shBLOCK/SnapNodes-RP2/hardware/PCB/Core_Length_Tuning_Profile.xlsx

Sheet: QSPI
SIGNAL | SEG1(MCU-SPI FLASH) | SEG2(SPI FLASH-PSRAM) | TOTAL | COMMENT | LEGEND
SCK | 14.852 | 15.5466 | 30.3986 |  |  | CHOSEN REFERENCE
D0 | 11.1338 | 15.5466 | 26.6804 |  |  | NOT GOOD
D1 | 14.852 | 14.0944 | 28.9464 |  |  | IGNORED
D2 | 14.852 | 15.5466 | 30.3986
D3 | 14.852 | 15.5466 | 30.3986
CS0 | 14.852 | 0 | 14.852
CS1 | 30.3986 | 0 | 30.3986 | USE TOTAL LENGTH AS REFERENCE |  | UNIT:mm

Sheet: PA
SIGNAL | SEG1(MCU-R) | SEG2(R-CONN) | TOTAL | COMMENT | LEGEND
CA | 12.7391 | 5.8326 | 18.5717 |  |  | CHOSEN REFERENCE
D0 | 16.706 | 1.8657 | 18.5717 |  |  | NOT GOOD
D1 | 17.3817 | 1.19 | 18.5717 |  |  | IGNORED
D2 | 17.3817 | 1.19 | 18.5717
D3 | 17.3817 | 1.19 | 18.5717
CB | 17.3817 | 1.19 | 18.5717
 |  |  |  |  |  | UNIT:mm

Sheet: PB
SIGNAL | SEG1(MCU-R) | SEG2(R-CONN) | TOTAL | COMMENT | LEGEND
CA | 26.7745 | 1.19 | 27.9645 |  |  | CHOSEN REFERENCE
D0 | 26.7745 | 1.19 | 27.9645 |  |  | NOT GOOD
D1 | 26.7745 | 1.19 | 27.9645 |  |  | IGNORED
D2 | 26.6745 | 1.29 | 27.9645
D3 | 26.6745 | 1.29 | 27.9645
CB | 26.6745 | 1.29 | 27.9645
 |  |  |  |  |  | UNIT:mm

Sheet: PC
SIGNAL | SEG1(MCU-R) | SEG2(R-CONN) | TOTAL | COMMENT | LEGEND
CA | 37.7886 | 1.19 | 38.9786 |  |  | CHOSEN REFERENCE
D0 | 37.7886 | 1.19 | 38.9786 |  |  | NOT GOOD
D1 | 37.7886 | 1.19 | 38.9786 |  |  | IGNORED
D2 | 36.8986 | 2.08 | 38.9786
D3 | 36.8986 | 2.08 | 38.9786
CB | 36.8986 | 2.08 | 38.9786
 |  |  |  |  |  | UNIT:mm

Sheet: PD
SIGNAL | SEG1(MCU-R) | SEG2(R-CONN) | TOTAL | COMMENT | LEGEND
CA | 24.7843 | 1.19 | 25.9743 |  |  | CHOSEN REFERENCE
D0 | 24.7843 | 1.19 | 25.9743 |  |  | NOT GOOD
D1 | 24.7843 | 1.19 | 25.9743 |  |  | IGNORED
D2 | 24.6742 | 1.3001 | 25.9743
D3 | 24.9742 | 1.0001 | 25.9743
CB | 24.7045 | 1.2698 | 25.9743
 |  |  |  |  |  | UNIT:mm
