shBLOCK/SnapNodes-RP2/hardware/PCB/SnapNodes_Breakout.kicad_pcb

## KiCad design hardware/PCB/SnapNodes_Breakout.kicad_pcb (2026-09-01)

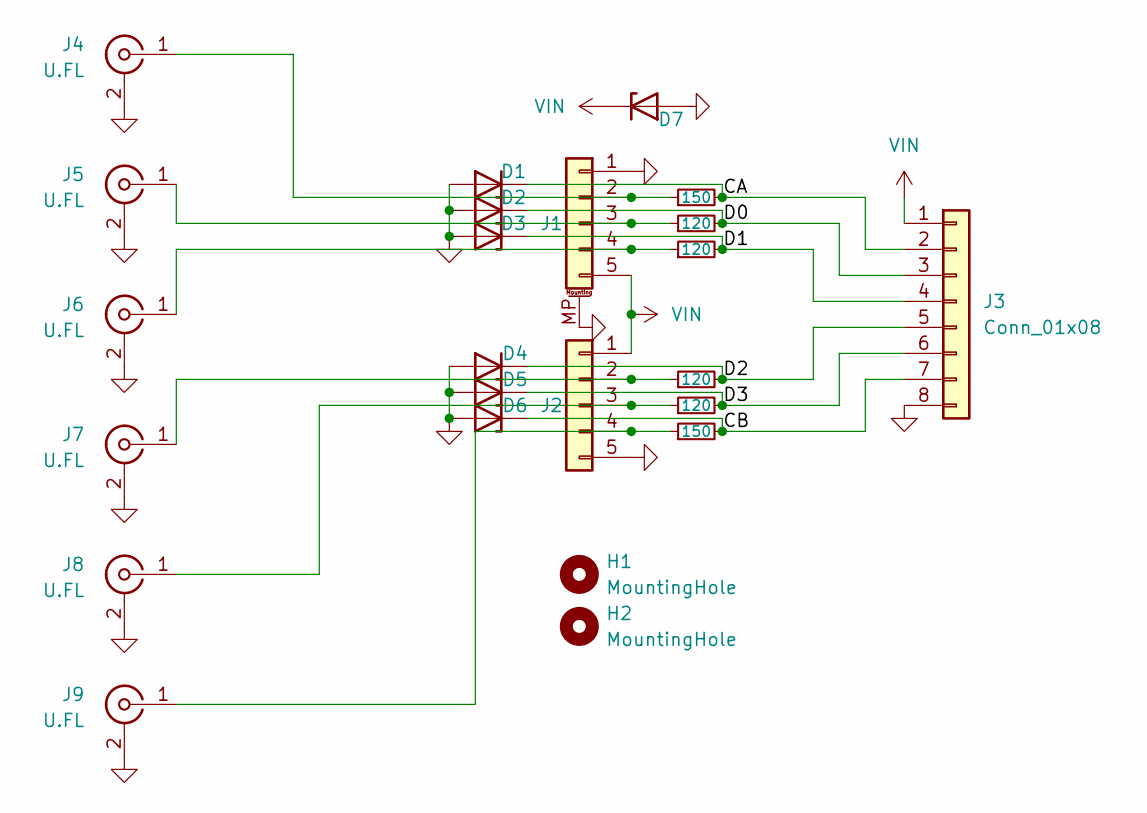
[picture p1: schematic SnapNodes_Breakout.kicad_sch, SnapNodes Breakout Board]

Parts:
D1, D2, D3, D4, D5, D6: PESD3V3S1BA; D_SOD-523; LCSC P/N C46550846
D7: PESD5V0S1BA; D_SOD-523; LCSC P/N C314264
H1, H2: MountingHole; MountingHole_2.2mm_M2
J1: P_Male; BC-15-5P380
J2: P_Female; BC-20-5PD160
J3: Conn_01x08; PinHeader_1x08_P2.54mm_Vertical
J4, J5, J6, J7, J8, J9: U.FL; U.FL_Hirose_U.FL-R-SMT-1_Vertical
R1, R6: 150; R_0402_1005Metric; LCSC P/N C25082
R2, R3, R4, R5: 120; R_0402_1005Metric; LCSC P/N C25079

Connections:
/CA: D1.1 (K), J3.2, R1.2
/CB: D6.1 (K), J3.7, R6.2
/D0: D2.1 (K), J3.3, R2.2
/D1: D3.1 (K), J3.4, R3.2
/D2: D4.1 (K), J3.5, R4.2
/D3: D5.1 (K), J3.6, R5.2
GND: D1.2 (A), D2.2 (A), D3.2 (A), D4.2 (A), D5.2 (A), D6.2 (A), D7.2 (A), J1.1, J1.MP (MountPin), J2.5, J3.8, J4.2 (Ext), J5.2 (Ext), J6.2 (Ext), J7.2 (Ext), J8.2 (Ext), J9.2 (Ext)
unnamed: J1.2, J4.1 (In), R1.1
unnamed: J1.3, J5.1 (In), R2.1
unnamed: J1.4, J6.1 (In), R3.1
unnamed: J2.2, J7.1 (In), R4.1
unnamed: J2.3, J8.1 (In), R5.1
unnamed: J2.4, J9.1 (In), R6.1
VIN: D7.1 (K), J1.5, J2.1, J3.1

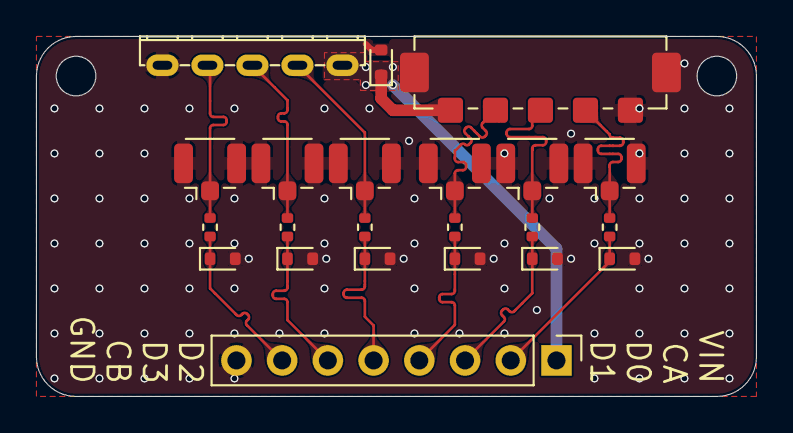
[picture p2: board SnapNodes_Breakout.kicad_pcb from above]

Board: 4 copper layers, 40.0 x 20.0 mm, 24 parts (0 on the bottom side), 14 nets.
