shBLOCK/SnapNodes-RP2/hardware/PCB/SnapNodes-RP2_Core.kicad_pcb

## KiCad design hardware/PCB/SnapNodes-RP2_Core.kicad_pcb (2026-09-01)

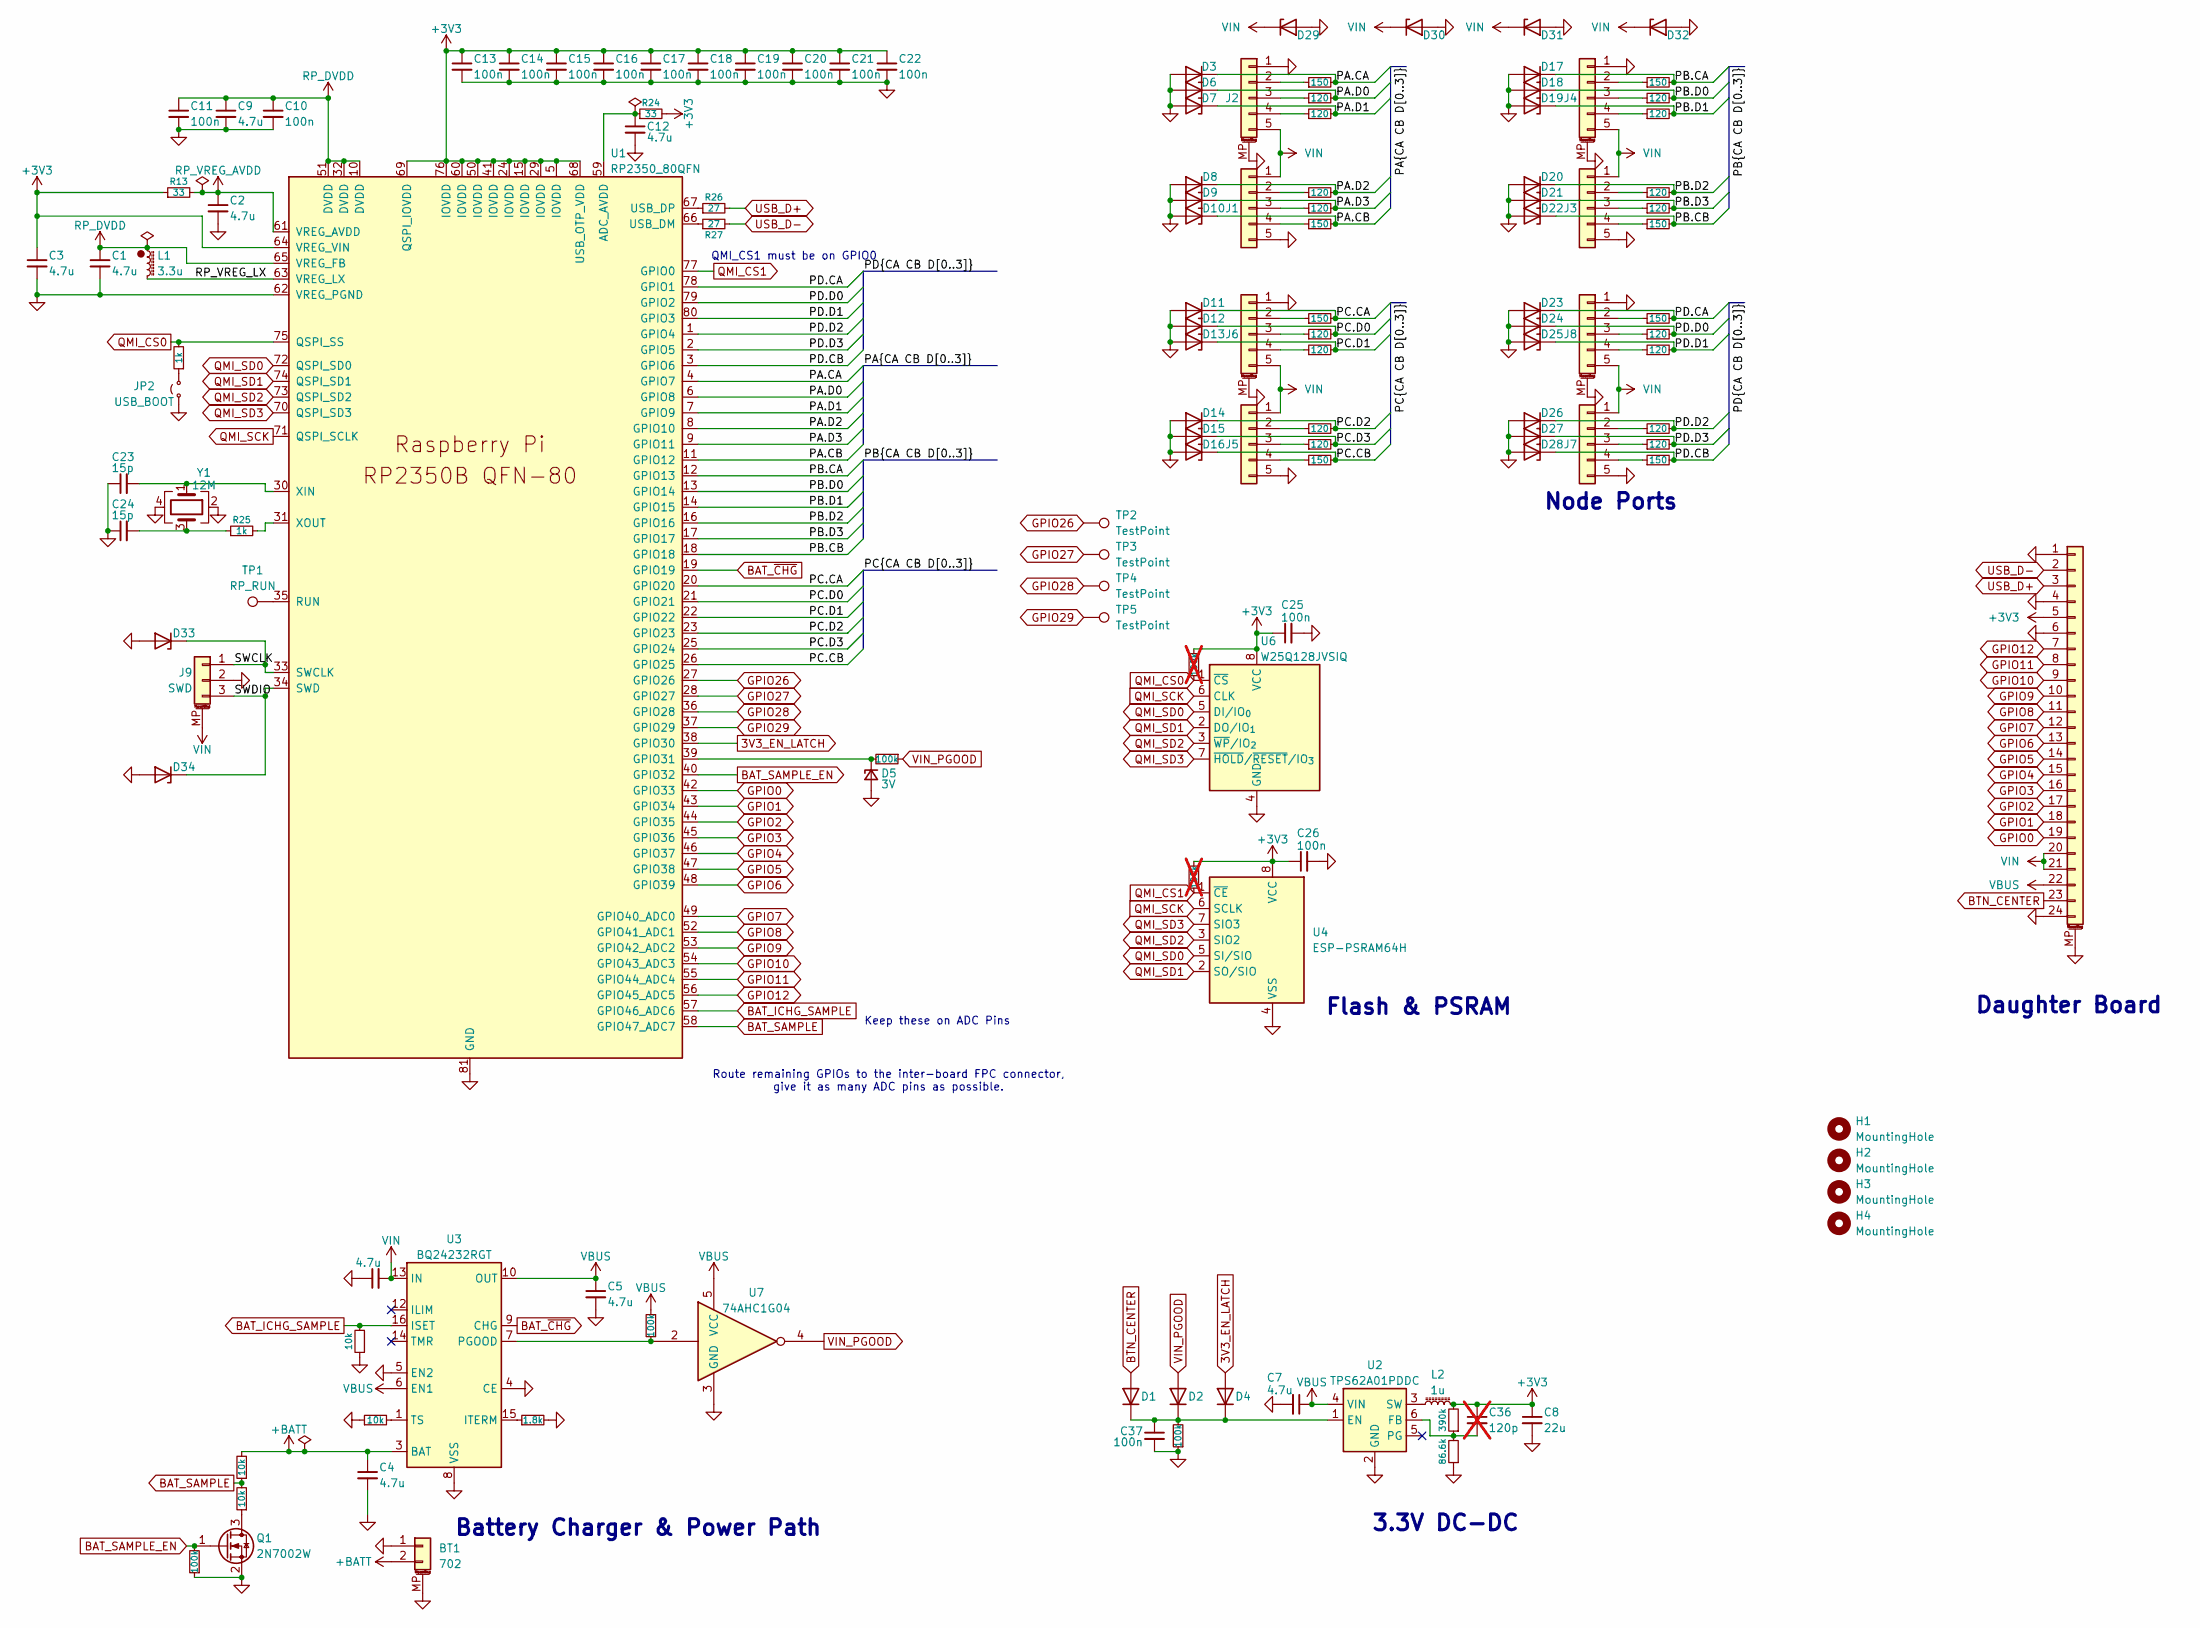
[picture p3: schematic SnapNodes-RP2_Core.kicad_sch, SnapNodes RP2 Core]

Parts:
BT1: 702; Molex_PicoBlade_53261-0271_1x02-1MP_P1.25mm_Horizontal; LCSC P/N C53477378
C1, C3: 4.7u; C_0402_1005Metric_small_pads; LCSC P/N C19666
C2, C4, C5, C6, C7, C9, C12: 4.7u; C_0402_1005Metric; LCSC P/N C19666
C8: 22u; C_0805_2012Metric; LCSC P/N C45783
C10, C11, C13, C14, C15, C16, C17, C18, C19, C20, C21, C22, C25, C26, C37: 100n; C_0402_1005Metric; LCSC P/N C1525
C23, C24: 15p; C_0402_1005Metric; LCSC P/N C1548
C36: 120p; C_0402_1005Metric; LCSC P/N C106996; not fitted
D1, D2, D4: 1N4148WT; D_SOD-523; LCSC P/N C7420320
D3, D6, D7, D8, D9, D10, D11, D12, D13, D14, D15, D16, D17, D18, D19, D20, D21, D22, D23, D24, D25, D26, D27, D28, D33, D34: PESD3V3S1BA; D_SOD-523; LCSC P/N C46550846
D5: 3V; D_SOD-523; LCSC P/N C2910134
D29, D30, D31, D32: PESD5V0S1BA; D_SOD-523; LCSC P/N C314264
H1, H2, H3, H4: MountingHole; MountingHole_2.2mm_M2
J1, J3, J5, J7: P_Female; BC-20-5PD160
J2, J4, J6, J8: P_Male; BC-15-5P380
J9: SWD; JST_SH_SM03B-SRSS-TB_1x03-1MP_P1.00mm_Horizontal; LCSC P/N C7430445
J20: Conn_01x24_MountingPin; FPC_Verticle_24pin_0.5mm; LCSC P/N C481246
JP2: USB_BOOT; PinHeader_1x02_P1.00mm_Vertical
L1: 3.3u; L_pol_2016; LCSC P/N C42411119
L2: 1u; L_Wuerth_MAPI-2010; LCSC P/N C7471163
Q1: 2N7002W; SOT-323_SC-70; LCSC P/N C7420322
R1, R4, R7, R10, R33, R37, R40, R43: 150; R_0402_1005Metric; LCSC P/N C25082
R2, R3, R5, R6, R8, R9, R11, R12, R31, R32, R35, R36, R38, R39, R41, R42: 120; R_0402_1005Metric; LCSC P/N C25079
R13, R24: 33; R_0402_1005Metric; LCSC P/N C25105
R14, R15, R17, R18: 10k; R_0402_1005Metric; LCSC P/N C25744
R16: 1.8k; R_0402_1005Metric; LCSC P/N C25871
R19, R22, R23, R34: 100k; R_0402_1005Metric; LCSC P/N C25741
R20: 86.6k; R_0402_1005Metric; LCSC P/N C19709
R21: 390k; R_0402_1005Metric; LCSC P/N C163467
R25, R30: 1k; R_0402_1005Metric; LCSC P/N C11702
R26, R27: 27; R_0402_1005Metric; LCSC P/N C25100
R28, R29: 100k; R_0402_1005Metric; LCSC P/N C25741; not fitted
TP1: RP_RUN; TestPoint_THTPad_D1.0mm_Drill0.5mm
TP2, TP3, TP4, TP5: TestPoint; TestPoint_Pad_D1.0mm
U1: RP2350_80QFN; RP2350-QFN-80-1EP_10x10_P0.4mm_EP3.4x3.4mm_ThermalVias; LCSC P/N C42415655
U2: TPS62A01PDDC; SOT-23-6; LCSC P/N C42267816
U3: BQ24232RGT; VQFN-16-1EP_3x3mm_P0.5mm_EP1.68x1.68mm_ThermalVias; LCSC P/N C528622
U4: ESP-PSRAM64H; SOIC-8_3.9x4.9mm_P1.27mm
U6: W25Q128JVSIQ; SOIC-8_5.3x5.3mm_P1.27mm; LCSC C113767
U7: 74AHC1G04; SOT-353_SC-70-5; LCSC P/N C52140422
Y1: 12M; Crystal_SMD_3225-4Pin_3.2x2.5mm; LCSC P/N C50430

Connections:
3V3_EN_LATCH: D4.2 (A), U1.38 (GPIO30)
+3V3: C3.1, C8.1, C13.1, C14.1, C15.1, C16.1, C17.1, C18.1, C19.1, C20.1, C21.1, C22.1, C25.1, C26.1, C36.1, J20.5, L2.2, R13.1, R21.2, R24.2, R28.2, R29.2, U1.5 (IOVDD), U1.15 (IOVDD), U1.24 (IOVDD), U1.29 (IOVDD), U1.41 (IOVDD), U1.50 (IOVDD), U1.60 (IOVDD), U1.64 (VREG_VIN), U1.68 (USB_OTP_VDD), U1.69 (QSPI_IOVDD), U1.76 (IOVDD), U4.8 (VCC), U6.8 (VCC)
+BATT: BT1.2, C4.1, R18.2, U3.2 (BAT), U3.3 (BAT)
/PA.CA: D3.1 (K), R1.2, U1.4 (GPIO7)
/PA.CB: D10.1 (K), R33.2, U1.11 (GPIO12)
/PA.D0: D6.1 (K), R31.2, U1.6 (GPIO8)
/PA.D1: D7.1 (K), R2.2, U1.7 (GPIO9)
/PA.D2: D8.1 (K), R32.2, U1.8 (GPIO10)
/PA.D3: D9.1 (K), R3.2, U1.9 (GPIO11)
/PB.CA: D17.1 (K), R4.2, U1.12 (GPIO13)
/PB.CB: D22.1 (K), R40.2, U1.18 (GPIO18)
/PB.D0: D18.1 (K), R38.2, U1.13 (GPIO14)
/PB.D1: D19.1 (K), R5.2, U1.14 (GPIO15)
/PB.D2: D20.1 (K), R39.2, U1.16 (GPIO16)
/PB.D3: D21.1 (K), R6.2, U1.17 (GPIO17)
/PC.CA: D11.1 (K), R7.2, U1.20 (GPIO20)
/PC.CB: D16.1 (K), R37.2, U1.26 (GPIO25)
/PC.D0: D12.1 (K), R35.2, U1.21 (GPIO21)
/PC.D1: D13.1 (K), R8.2, U1.22 (GPIO22)
/PC.D2: D14.1 (K), R36.2, U1.23 (GPIO23)
/PC.D3: D15.1 (K), R9.2, U1.25 (GPIO24)
/PD.CA: D23.1 (K), R10.2, U1.78 (GPIO1)
/PD.CB: D28.1 (K), R43.2, U1.3 (GPIO6)
/PD.D0: D24.1 (K), R41.2, U1.79 (GPIO2)
/PD.D1: D25.1 (K), R11.2, U1.80 (GPIO3)
/PD.D2: D26.1 (K), R42.2, U1.1 (GPIO4)
/PD.D3: D27.1 (K), R12.2, U1.2 (GPIO5)
/RP_VREG_LX: L1.2, U1.63 (VREG_LX)
/SWCLK: D33.1 (K), J9.1, U1.33 (SWCLK)
/SWDIO: D34.1 (K), J9.3, U1.34 (SWD)
BAT_ICHG_SAMPLE: R15.2, U1.57 (GPIO46_ADC6), U3.16 (ISET)
BAT_SAMPLE: R17.2, R18.1, U1.58 (GPIO47_ADC7)
BAT_SAMPLE_EN: Q1.1 (G), R19.2, U1.40 (GPIO32)
BAT_~CHG: U1.19 (GPIO19), U3.9 (CHG)
BTN_CENTER: D1.2 (A), J20.23
GND: BT1.1, BT1.MP (MountPin), C1.2, C2.2, C3.2, C4.2, C5.2, C6.1, C7.2, C8.2, C9.2, C10.2, C11.2, C12.2, C13.2, C14.2, C15.2, C16.2, C17.2, C18.2, C19.2, C20.2, C21.2, C22.2, C23.1, C24.1, C25.2, C26.2, C37.2, D3.2 (A), D5.2 (A), D6.2 (A), D7.2 (A), D8.2 (A), D9.2 (A), D10.2 (A), D11.2 (A), D12.2 (A), D13.2 (A), D14.2 (A), D15.2 (A), D16.2 (A), D17.2 (A), D18.2 (A), D19.2 (A), D20.2 (A), D21.2 (A), D22.2 (A), D23.2 (A), D24.2 (A), D25.2 (A), D26.2 (A), D27.2 (A), D28.2 (A), D29.2 (A), D30.2 (A), D31.2 (A), D32.2 (A), D33.2 (A), D34.2 (A), J1.5, J2.1, J2.MP (MountPin), J3.5, J4.1, J4.MP (MountPin), J5.5, J6.1, J6.MP (MountPin), J7.5, J8.1, J8.MP (MountPin), J9.2, J9.MP (MountPin), J20.1, J20.4, J20.6, J20.24, J20.MP (MountPin), JP2.1 (A), Q1.2 (S), R14.1, R15.1, R16.2, R19.1, R20.1, R34.1, U1.62 (VREG_PGND), U1.81 (GND), U2.2 (GND), U3.4 (CE), U3.5 (EN2), U3.8 (VSS), U3.17 (VSS), U4.4 (VSS), U6.4 (GND), U7.3 (GND), Y1.2, Y1.4
GPIO0: J20.19, U1.42 (GPIO33)
GPIO1: J20.18, U1.43 (GPIO34)
GPIO2: J20.17, U1.44 (GPIO35)
GPIO3: J20.16, U1.45 (GPIO36)
GPIO4: J20.15, U1.46 (GPIO37)
GPIO5: J20.14, U1.47 (GPIO38)
GPIO6: J20.13, U1.48 (GPIO39)
GPIO7: J20.12, U1.49 (GPIO40_ADC0)
GPIO8: J20.11, U1.52 (GPIO41_ADC1)
GPIO9: J20.10, U1.53 (GPIO42_ADC2)
GPIO10: J20.9, U1.54 (GPIO43_ADC3)
GPIO11: J20.8, U1.55 (GPIO44_ADC4)
GPIO12: J20.7, U1.56 (GPIO45_ADC5)
GPIO26: TP2.1 (1_1), U1.27 (GPIO26)
GPIO27: TP3.1 (1_1), U1.28 (GPIO27)
GPIO28: TP4.1 (1_1), U1.36 (GPIO28)
GPIO29: TP5.1 (1_1), U1.37 (GPIO29)
unnamed: C24.2, R25.1, Y1.3
unnamed: C37.1, D1.1 (K), D2.1 (K), D4.1 (K), R34.2, U2.1 (EN)
unnamed: D5.1 (K), R23.2, U1.39 (GPIO31)
unnamed: J1.2, R32.1
unnamed: J1.3, R3.1
unnamed: J1.4, R33.1
unnamed: J2.2, R1.1
unnamed: J2.3, R31.1
unnamed: J2.4, R2.1
unnamed: J3.2, R39.1
unnamed: J3.3, R6.1
unnamed: J3.4, R40.1
unnamed: J4.2, R4.1
unnamed: J4.3, R38.1
unnamed: J4.4, R5.1
unnamed: J5.2, R36.1
unnamed: J5.3, R9.1
unnamed: J5.4, R37.1
unnamed: J6.2, R7.1
unnamed: J6.3, R35.1
unnamed: J6.4, R8.1
unnamed: J7.2, R42.1
unnamed: J7.3, R12.1
unnamed: J7.4, R43.1
unnamed: J8.2, R10.1
unnamed: J8.3, R41.1
unnamed: J8.4, R11.1
unnamed: JP2.2 (B), R30.1
unnamed: Q1.3 (D), R17.1
unnamed: C12.1, R24.1, U1.59 (ADC_AVDD)
unnamed: TP1.1 (1_1), U1.35 (RUN)
unnamed: R27.1, U1.66 (USB_DM)
unnamed: R26.1, U1.67 (USB_DP)
unnamed: C23.2, U1.30 (XIN), Y1.1
unnamed: R25.2, U1.31 (XOUT)
unnamed: C36.2, R20.2, R21.1, U2.6 (FB)
unnamed: L2.1, U2.3 (SW)
unnamed: R16.1, U3.15 (ITERM)
unnamed: R22.2, U3.7 (PGOOD), U7.2
unnamed: R14.2, U3.1 (TS)
QMI_CS0: R28.1, R30.2, U1.75 (QSPI_SS), U6.1 (~CS)
QMI_CS1: R29.1, U1.77 (GPIO0), U4.1 (~CE)
QMI_SCK: U1.71 (QSPI_SCLK), U4.6 (SCLK), U6.6 (CLK)
QMI_SD0: U1.72 (QSPI_SD0), U4.5 (SI/SIO), U6.5 (DI/IO_{0})
QMI_SD1: U1.74 (QSPI_SD1), U4.2 (SO/SIO), U6.2 (DO/IO_{1})
QMI_SD2: U1.73 (QSPI_SD2), U4.3 (SIO2), U6.3 (~WP/IO_{2})
QMI_SD3: U1.70 (QSPI_SD3), U4.7 (SIO3), U6.7 (~HOLD/~RESET/IO_{3})
RP_DVDD: C1.1, C9.1, C10.1, C11.1, L1.1, U1.10 (DVDD), U1.32 (DVDD), U1.51 (DVDD), U1.65 (VREG_FB)
RP_VREG_AVDD: C2.1, R13.2, U1.61 (VREG_AVDD)
USB_D+: J20.3, R26.2
USB_D-: J20.2, R27.2
VBUS: C5.1, C7.1, J20.22, R22.1, U2.4 (VIN), U3.6 (EN1), U3.10 (OUT), U3.11 (OUT), U7.5 (VCC)
VIN: C6.2, D29.1 (K), D30.1 (K), D31.1 (K), D32.1 (K), J1.1, J2.5, J3.1, J4.5, J5.1, J6.5, J7.1, J8.5, J9.MP (MountPin), J20.20, J20.21, U3.13 (IN)
VIN_PGOOD: D2.2 (A), R23.1, U7.4

Notes on the sheet:
Battery Charger & Power Path
Route remaining GPIOs to the inter-board FPC connector, give it as many ADC pins as possible.
QMI_CS1 must be on GPIO0
Node Ports
Keep these on ADC Pins
Daughter Board
3.3V DC-DC
Flash & PSRAM

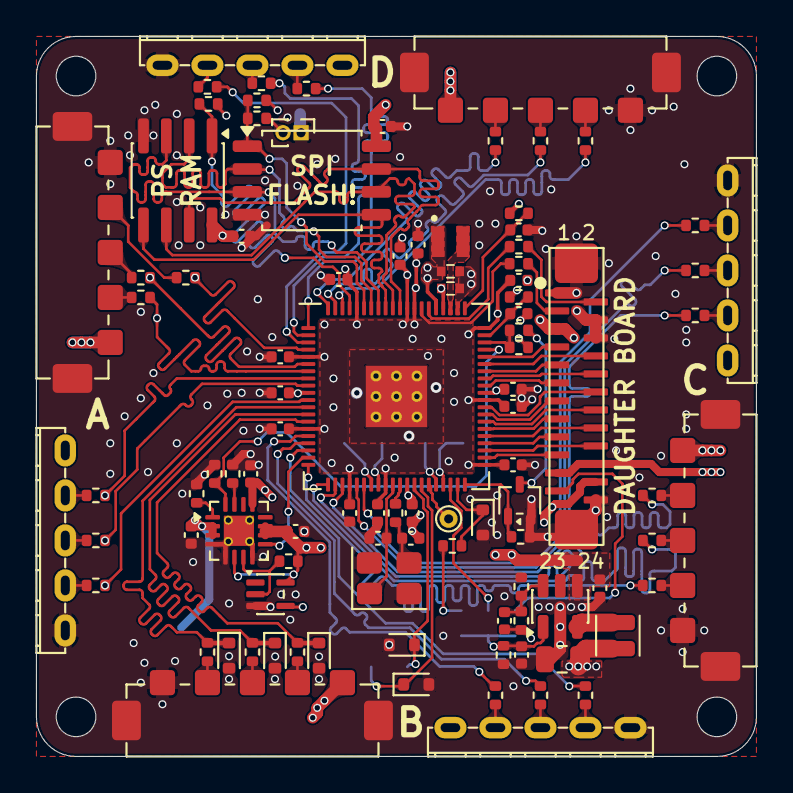
[picture p4: board SnapNodes-RP2_Core.kicad_pcb from above]

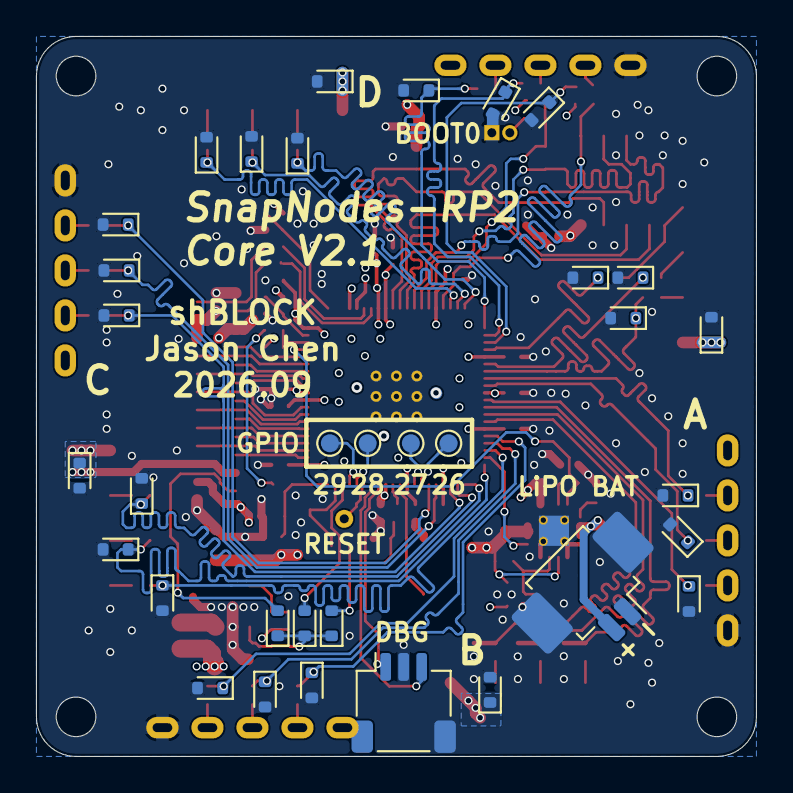
[picture p5: board SnapNodes-RP2_Core.kicad_pcb from below]

Board: 4 copper layers, 40.0 x 40.0 mm, 136 parts (34 on the bottom side), 107 nets.
