shBLOCK/SnapNodes-RP2/hardware/PCB/SnapNodes-RP2_HAT_MediaLCD.kicad_pcb

## KiCad design hardware/PCB/SnapNodes-RP2_HAT_MediaLCD.kicad_pcb (2026-09-01)

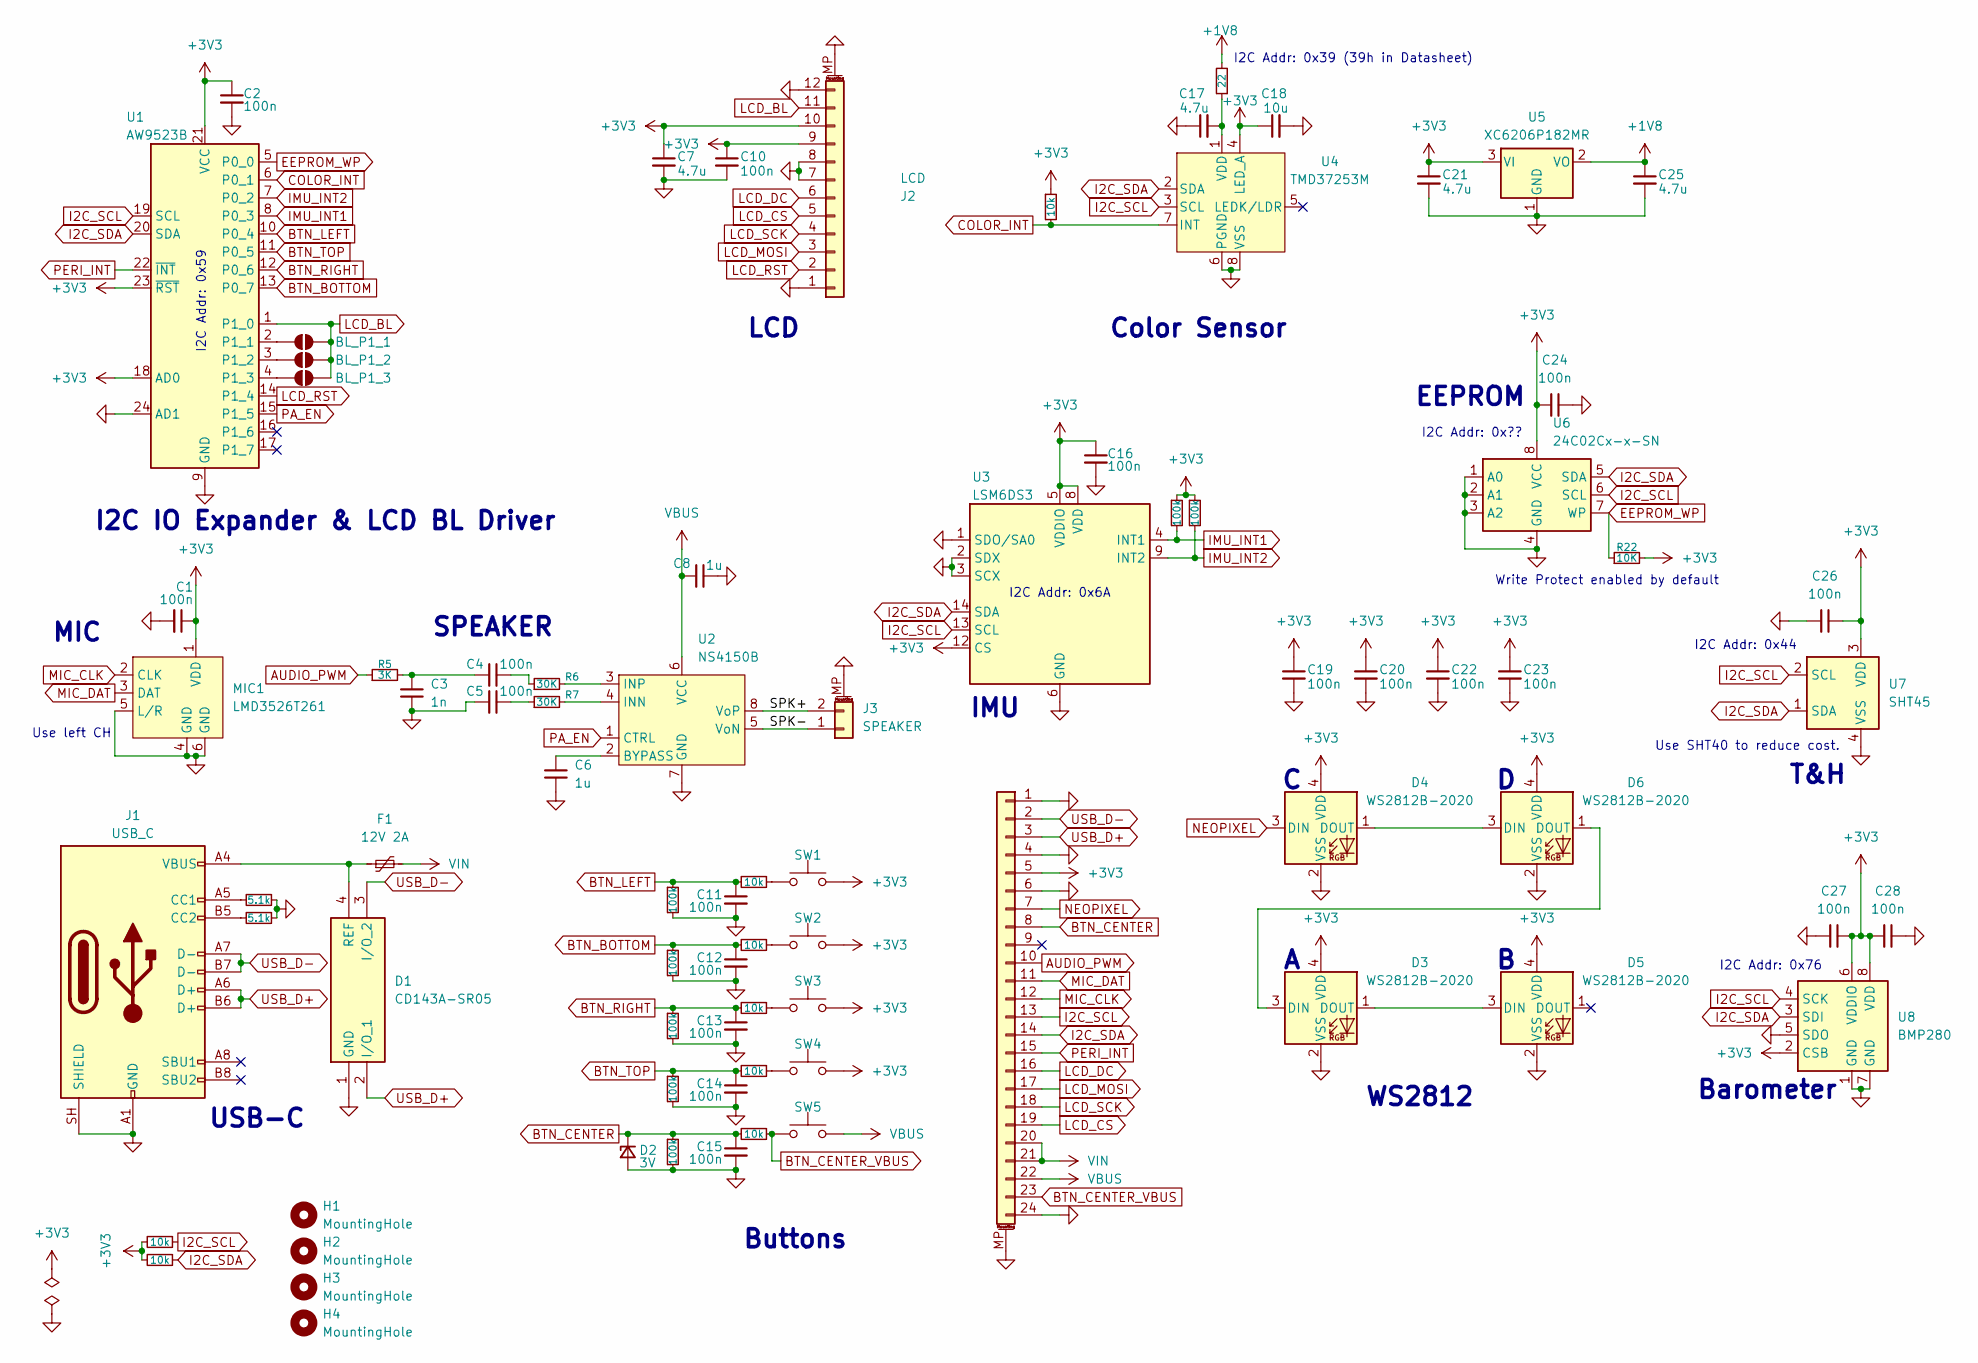
[picture p6: schematic SnapNodes-RP2_HAT_MediaLCD.kicad_sch, SnapNodes-RP2 Hat]

Parts:
C1, C2, C4, C5, C10, C11, C12, C13, C14, C15, C16, C19, C20, C22, C23, C24, C26, C27, C28: 100n; C_0603_1608Metric; LCSC P/N C14663
C3: 1n; C_0603_1608Metric; LCSC P/N C1588
C6, C8: 1u; C_0603_1608Metric; LCSC P/N C15849
C7, C17, C21, C25: 4.7u; C_0603_1608Metric; LCSC P/N C19666
C18: 10u; C_0603_1608Metric; LCSC P/N C19702
D1: CD143A-SR05; SOT-143; Manufacturer_Part_Number CD143A-SR05; Mouser Part Number 652-CD143A-SR05
D2: 3V; D_SOD-523; LCSC P/N C2910134
D3, D4, D5, D6: WS2812B-2020; LED_WS2812B-2020_PLCC4_2.0x2.0mm; LCSC P/N C52917434
F1: 12V 2A; Fuse_0805_2012Metric; LCSC P/N C48783161
H1, H2, H3, H4: MountingHole; MountingHole_2.2mm_M2
J1: USB_C; USB_C_Receptacle_GCT_USB4105-xx-A_16P_TopMnt_Horizontal; LCSC P/N C2765186
J2: LCD; TE_1-1734839-2_1x12-1MP_P0.5mm_Horizontal; LCSC P/N C49274051
J3: SPEAKER; Molex_PicoBlade_53261-0271_1x02-1MP_P1.25mm_Horizontal; LCSC P/N C53477378
J4: Conn_01x24_MountingPin; FPC_Verticle_24pin_0.5mm; LCSC P/N C481246
JP1: BL_P1_1; SolderJumper-2_P1.3mm_Open_RoundedPad1.0x1.5mm
JP2: BL_P1_2; SolderJumper-2_P1.3mm_Open_RoundedPad1.0x1.5mm
JP3: BL_P1_3; SolderJumper-2_P1.3mm_Open_RoundedPad1.0x1.5mm
MIC1: LMD3526T261; MIC-SMD_6P-L3.5-W2.7-P0.884-TR; LCSC P/N C49230436
R1, R2, R13, R14, R15, R16, R17, R18: 10k; R_0603_1608Metric; LCSC P/N C25804
R3, R4: 5.1k; R_0603_1608Metric; LCSC P/N C23186
R5: 3K; R_0603_1608Metric; LCSC P/N C4211
R6, R7: 30K; R_0603_1608Metric; LCSC P/N C22984
R8, R9, R10, R11, R12, R19, R20: 100k; R_0603_1608Metric; LCSC P/N C25803
R21: 22; R_0603_1608Metric; LCSC P/N C23345
R22: 10K; R_0603_1608Metric; LCSC P/N C25804
SW1: Left; SW_SPST_PTS647_Sx38
SW2: Bottom; SW_SPST_PTS647_Sx38
SW3: Right; SW_SPST_PTS647_Sx38
SW4: Top; SW_SPST_PTS647_Sx38
SW5: Center; SW_SPST_PTS647_Sx38
U1: AW9523B; QFN-24-1EP_4x4mm_P0.5mm_EP2.7x2.7mm_ThermalVias; LCSC P/N C148077
U2: NS4150B; MSOP-8_3x3mm_P0.65mm; LCSC P/N C189961
U3: LSM6DS3; LGA-14_3x2.5mm_P0.5mm_LayoutBorder3x4y; LCSC P/N C95230
U4: TMD37253M; LGA8_TMD37253_OSM; LCSC P/N C2153068
U5: XC6206P182MR; SOT-23-3; LCSC P/N C347373
U6: 24C02Cx-x-SN; SOIC-8_3.9x4.9mm_P1.27mm
U7: SHT45; Sensirion_DFN-4_1.5x1.5mm_P0.8mm_SHT4x_NoCentralPad
U8: BMP280; Bosch_LGA-8_2x2.5mm_P0.65mm_ClockwisePinNumbering

Connections:
+1V8: C25.1, R21.2, U5.2 (VO)
+3V3: C1.1, C2.1, C7.1, C10.1, C16.1, C18.1, C19.1, C20.1, C21.1, C22.1, C23.1, C24.1, C26.2, C27.2, C28.1, D3.4 (VDD), D4.4 (VDD), D5.4 (VDD), D6.4 (VDD), J2.9, J2.10, J4.5, MIC1.1 (VDD), R1.2, R2.2, R18.1, R19.1, R20.1, R22.2, SW1.2, SW2.2, SW3.2, SW4.2, U1.18 (AD0), U1.21 (VCC), U1.23 (~RST), U3.5 (VDDIO), U3.8 (VDD), U3.12 (CS), U4.4 (LED_A), U5.3 (VI), U6.8 (VCC), U7.3 (VDD), U8.2 (CSB), U8.6 (VDDIO), U8.8 (VDD)
/SPK+: J3.2, U2.8 (VoP)
/SPK-: J3.1, U2.5 (VoN)
AUDIO_PWM: J4.10, R5.1
BTN_BOTTOM: C12.1, R9.1, R14.2, U1.13 (P0_7)
BTN_CENTER: C15.1, D2.1 (K), J4.8, R12.1, R17.2
BTN_CENTER_VBUS: J4.23, R17.1, SW5.1
BTN_LEFT: C11.1, R8.1, R13.2, U1.10 (P0_4)
BTN_RIGHT: C13.1, R10.1, R15.2, U1.12 (P0_6)
BTN_TOP: C14.1, R11.1, R16.2, U1.11 (P0_5)
COLOR_INT: R18.2, U1.6 (P0_1), U4.7 (INT)
EEPROM_WP: R22.1, U1.5 (P0_0), U6.7 (WP)
GND: C1.2, C2.2, C3.1, C5.1, C6.1, C7.2, C8.1, C10.2, C11.2, C12.2, C13.2, C14.2, C15.2, C16.2, C17.1, C18.2, C19.2, C20.2, C21.2, C22.2, C23.2, C24.2, C25.2, C26.1, C27.1, C28.2, D1.1 (GND), D2.2 (A), D3.2 (VSS), D4.2 (VSS), D5.2 (VSS), D6.2 (VSS), J1.A1 (GND), J1.A12 (GND), J1.B1 (GND), J1.B12 (GND), J1.SH (SHIELD), J2.1, J2.7, J2.8, J2.12, J2.MP (MountPin), J3.MP (MountPin), J4.1, J4.4, J4.6, J4.24, J4.MP (MountPin), MIC1.4 (GND), MIC1.5 (L/R), MIC1.6 (GND), R3.1, R4.1, R8.2, R9.2, R10.2, R11.2, R12.2, U1.9 (GND), U1.24 (AD1), U1.25 (GND), U2.7 (GND), U3.1 (SDO/SA0), U3.2 (SDX), U3.3 (SCX), U3.6 (GND), U3.7 (GND), U4.6 (PGND), U4.8 (VSS), U5.1 (GND), U6.1 (A0), U6.2 (A1), U6.3 (A2), U6.4 (GND), U7.4 (VSS), U8.1 (GND), U8.5 (SDO), U8.7 (GND)
I2C_SCL: J4.13, R1.1, U1.19 (SCL), U3.13 (SCL), U4.3 (SCL), U6.6 (SCL), U7.2 (SCL), U8.4 (SCK)
I2C_SDA: J4.14, R2.1, U1.20 (SDA), U3.14 (SDA), U4.2 (SDA), U6.5 (SDA), U7.1 (SDA), U8.3 (SDI)
IMU_INT1: R19.2, U1.8 (P0_3), U3.4 (INT1)
IMU_INT2: R20.2, U1.7 (P0_2), U3.9 (INT2)
LCD_BL: J2.11, JP1.2 (B), JP2.2 (B), JP3.2 (B), U1.1 (P1_0)
LCD_CS: J2.5, J4.19
LCD_DC: J2.6, J4.16
LCD_MOSI: J2.3, J4.17
LCD_RST: J2.2, U1.14 (P1_4)
LCD_SCK: J2.4, J4.18
MIC_CLK: J4.12, MIC1.2 (CLK)
MIC_DAT: J4.11, MIC1.3 (DAT)
NEOPIXEL: D4.3 (DIN), J4.7
unnamed: C3.2, C4.1, R5.2
unnamed: C4.2, R6.1
unnamed: C5.2, R7.1
unnamed: D1.4 (REF), F1.1, J1.A4 (VBUS), J1.A9 (VBUS), J1.B4 (VBUS), J1.B9 (VBUS)
unnamed: D3.3 (DIN), D6.1 (DOUT)
unnamed: D3.1 (DOUT), D5.3 (DIN)
unnamed: D4.1 (DOUT), D6.3 (DIN)
unnamed: J1.A5 (CC1), R3.2
unnamed: J1.B5 (CC2), R4.2
unnamed: JP1.1 (A), U1.2 (P1_1)
unnamed: JP2.1 (A), U1.3 (P1_2)
unnamed: JP3.1 (A), U1.4 (P1_3)
unnamed: R13.1, SW1.1
unnamed: R14.1, SW2.1
unnamed: R15.1, SW3.1
unnamed: R16.1, SW4.1
unnamed: C6.2, U2.2 (BYPASS)
unnamed: R7.2, U2.4 (INN)
unnamed: R6.2, U2.3 (INP)
unnamed: C17.2, R21.1, U4.1 (VDD)
PA_EN: U1.15 (P1_5), U2.1 (CTRL)
PERI_INT: J4.15, U1.22 (~INT)
USB_D+: D1.2 (I/O_1), J1.A6 (D+), J1.B6 (D+), J4.3
USB_D-: D1.3 (I/O_2), J1.A7 (D-), J1.B7 (D-), J4.2
VBUS: C8.2, J4.22, SW5.2, U2.6 (VCC)
VIN: F1.2, J4.20, J4.21

Notes on the sheet:
I2C IO Expander & LCD BL Driver
Barometer
SPEAKER
Color Sensor
USB-C
EEPROM
I2C Addr: 0x76
WS2812
Use left CH
MIC
Buttons
LCD
I2C Addr: 0x44
I2C Addr: 0x59
I2C Addr: 0x39 (39h in Datasheet)
I2C Addr: 0x6A
IMU
I2C Addr: 0x??
Use SHT40 to reduce cost.
Write Protect enabled by default
T&H

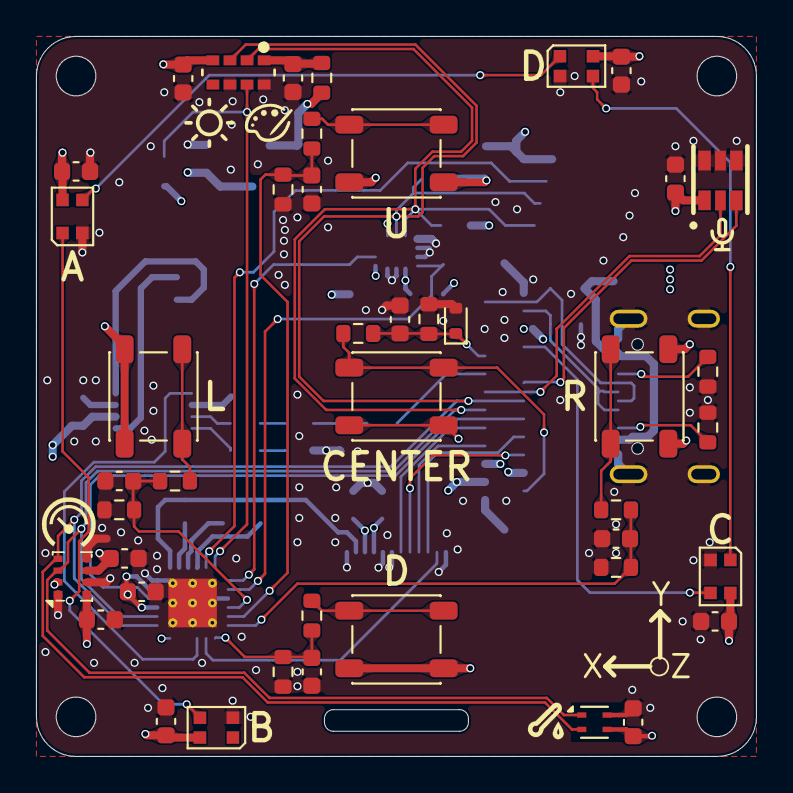
[picture p7: board SnapNodes-RP2_HAT_MediaLCD.kicad_pcb from above]

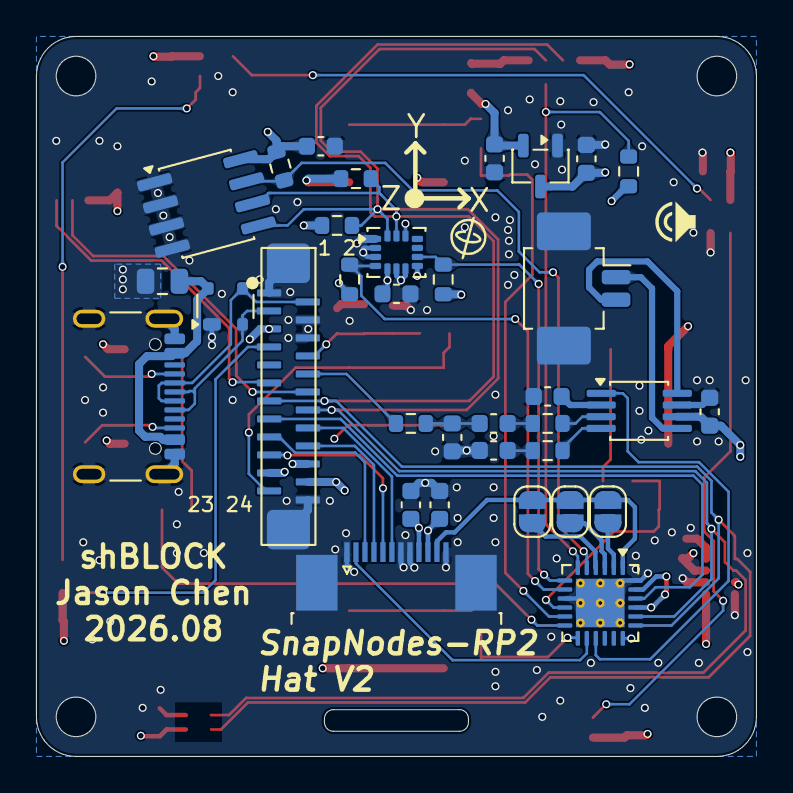
[picture p8: board SnapNodes-RP2_HAT_MediaLCD.kicad_pcb from below]

Board: 4 copper layers, 40.0 x 40.0 mm, 81 parts (34 on the bottom side), 53 nets.
