shBLOCK/SnapNodes-RP2/(commit log)

2026-01-17 Move PCB files from TileGlobeMC to this repo. Revision WIP
    [SnapNodes-RP2_Core.kicad_pcb, SnapNodes-RP2_Core.kicad_sch, SnapNodes-RP2_HAT_MediaLCD.kicad_pcb, SnapNodes-RP2_HAT_MediaLCD.kicad_sch]
2026-08-25 Hardware schematic revision
    [SnapNodes-RP2_Core.kicad_pcb, SnapNodes-RP2_Core.kicad_sch, SnapNodes-RP2_HAT_MediaLCD.kicad_pcb, SnapNodes-RP2_HAT_MediaLCD.kicad_sch]
2026-08-25 Schematic: remove fallback connectors
    [SnapNodes-RP2_Core.kicad_sch]
2026-08-29 SnapNode-RP2 Core V2 PCB
    [SnapNodes-RP2_Core.kicad_pcb, SnapNodes-RP2_Core.kicad_sch]
2026-08-31 HAT V2 PCB done, minor fix for Core PCB
    [SnapNodes-RP2_Core.kicad_pcb, SnapNodes-RP2_Core.kicad_sch, SnapNodes-RP2_HAT_MediaLCD.kicad_pcb, SnapNodes-RP2_HAT_MediaLCD.kicad_sch]
2026-09-01 all V2 PCBs done
    [SnapNodes-RP2_Core.kicad_pcb, SnapNodes-RP2_Core.kicad_sch, SnapNodes-RP2_HAT_MediaLCD.kicad_pcb, SnapNodes-RP2_HAT_MediaLCD.kicad_sch, SnapNodes_Breakout.kicad_pcb, SnapNodes_Breakout.kicad_sch]
2026-09-01 changed LCSC P/N of 5V TVS, moved a MLCC that conflicts with FPC connector on core board
    [SnapNodes-RP2_Core.kicad_pcb, SnapNodes-RP2_Core.kicad_sch, SnapNodes_Breakout.kicad_pcb, SnapNodes_Breakout.kicad_sch]
2026-09-03 add length tuning profile
    [Core_Length_Tuning_Profile.xlsx]
